PNevins971/TeamAvalanche/Notes and Research/uc_to_antenna - schematic draft - Dmitrii.docx

Using the formula below (source (https://physics.nyu.edu/~physlab/GenPhysI_PhysII/Intro_experimental_physicsII_write_ups/Magnetic-field-circular-coil_01_30_2017.pdf))

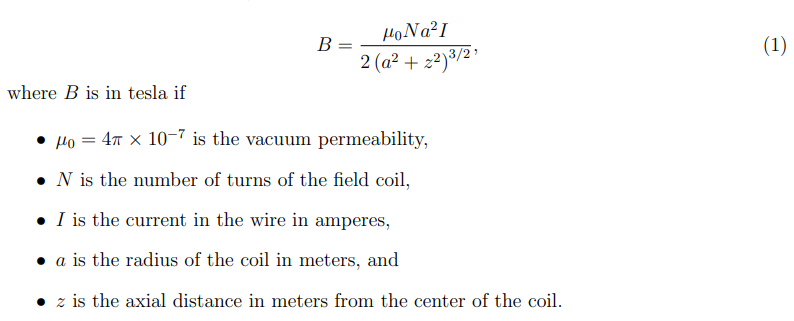
[picture p1: figure]

The current to output to antenna is estimated to be 2 A:

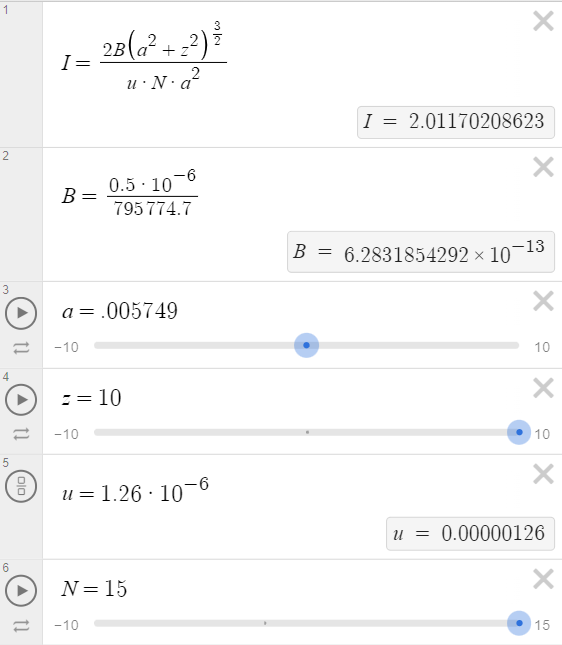
[picture p2: figure]

This can be achieved with the circuit below:

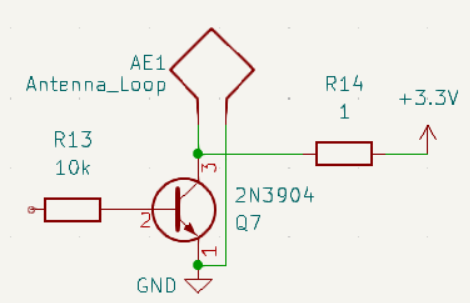
[picture p3: figure]
