PNevins971/TeamAvalanche/Breadboard_Layout_bb.pdf

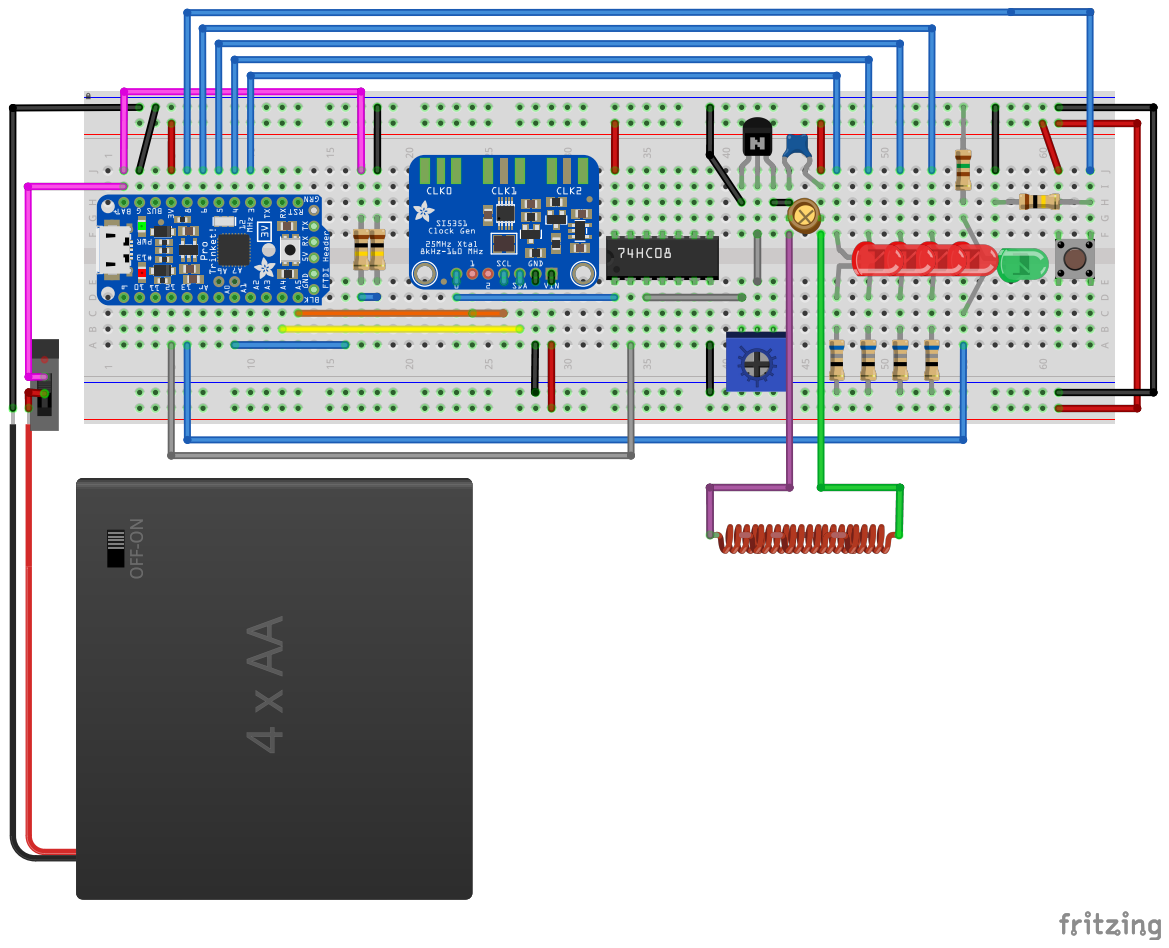
[picture p17: page 1]
