PNevins971/TeamAvalanche/(list of files, drawings)

Other design files:
Breadboard_Layout.fzz
