PNevins971/TeamAvalanche/PCB_design/avalanche_transmitter.kicad_pcb

## KiCad design PCB_design/avalanche_transmitter.kicad_pcb (2024-05-27)

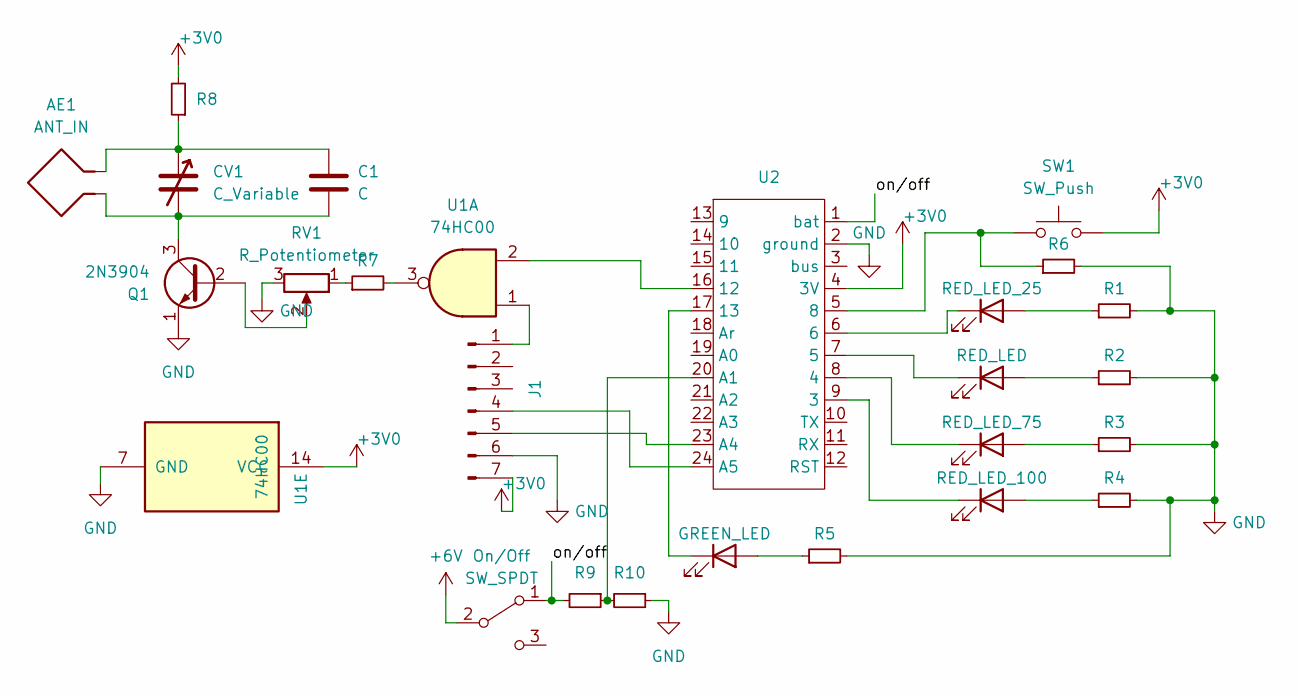
[picture p18: schematic avalanche_transmitter.kicad_sch]

Parts:
25%: RED_LED_100; LED_D5.0mm
50%: RED_LED_75; LED_D5.0mm
75%: RED_LED; LED_D5.0mm
100%: RED_LED_25; LED_D5.0mm
AE1: ANT_IN; PinHeader_1x02_P2.54mm_Vertical
C1: C; C_Disc_D4.7mm_W2.5mm_P5.00mm
CV1: C_Variable; C_Disc_D4.7mm_W2.5mm_P5.00mm
J1: Conn_01x07_Pin; PinHeader_1x07_P2.54mm_Vertical
On/Off: SW_SPDT; PinHeader_1x03_P2.54mm_Vertical
Q1: 2N3904; TO-92_Inline
R1, R2, R3, R4, R5, R6, R7, R8, R9, R10: R_Small; R_Axial_DIN0204_L3.6mm_D1.6mm_P7.62mm_Horizontal
RV1: R_Potentiometer; Potentiometer_Bourns_3296W_Vertical
SW1: SW_Push
TRANSMITTING: GREEN_LED; LED_D5.0mm
U1: 74HC00; DIP-14_W7.62mm
U2: pro_mini

Connections:
+3V0: J1.7, R8.2, SW1.2, U1.14 (VCC), U2.4 (3V)
+6V: On/Off.2 (B); also elsewhere on the board
/on/off: On/Off.1 (A), R9.2, U2.1 (bat)
GND: J1.6, Q1.1 (E), R1.2, R2.2, R3.2, R4.2, R5.2, R6.2, R10.1, RV1.3, U1.7 (GND), U2.2 (ground); also elsewhere on the board
unnamed: 75%.2 (A), R2.1
unnamed: 75%.1 (K), U2.7 (5)
unnamed: 50%.2 (A), R3.1
unnamed: 50%.1 (K), U2.8 (4)
unnamed: 25%.2 (A), R4.1
unnamed: 25%.1 (K), U2.9 (3)
unnamed: AE1.2, C1.1, CV1.1, R8.1
unnamed: 100%.2 (A), R1.1
unnamed: 100%.1 (K), U2.6
unnamed: J1.1, U1.1
unnamed: J1.4, U2.24 (A5)
unnamed: J1.5, U2.23 (A4)
unnamed: Q1.2 (B), RV1.2
unnamed: AE1.1, C1.2, CV1.2, Q1.3 (C)
unnamed: R7.1, RV1.1
unnamed: R7.2, U1.3
unnamed: R5.1, TRANSMITTING.2 (A)
unnamed: TRANSMITTING.1 (K), U2.17 (13)
unnamed: R6.1, SW1.1, U2.5 (8)
unnamed: U1.2, U2.16 (12)
unnamed: R9.1, R10.2, U2.20 (A1)

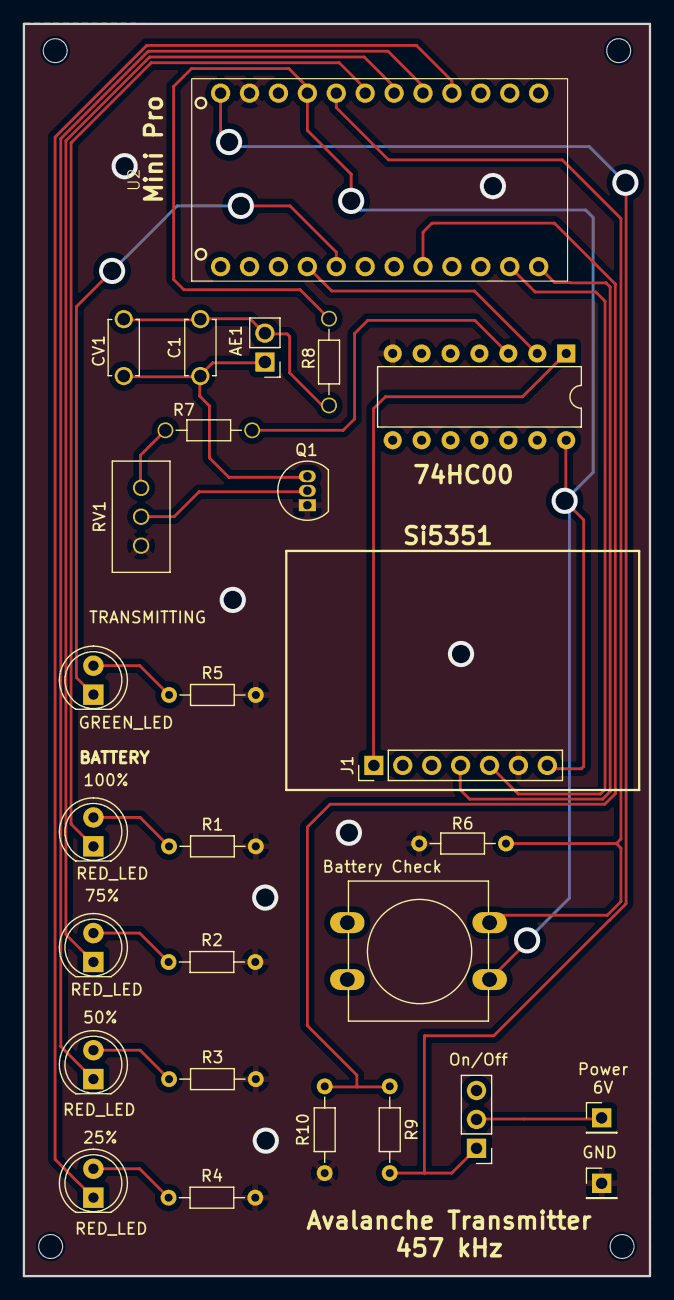
[picture p19: board avalanche_transmitter.kicad_pcb from above]

Board: 2 copper layers, 55.0 x 110.0 mm, 26 parts (0 on the bottom side), 25 nets.

Other parts of the board:
Battery In (6V): PinHeader_1x01_P2.54mm_Vertical
GND: PinHeader_1x01_P2.54mm_Vertical

Their connections:
+6V: Battery In (6V).1; also elsewhere on the board
GND: GND.1; also elsewhere on the board
