PNevins971/TeamAvalanche/(commit log)

2024-04-05 code to program IC via raspberry pi i2c
2024-04-09 Update si5351_init.ino
    tested on adafruit trinket
    and rasp pi pico
2024-04-16 Update arduinoTrinketCode_withDigitalSW.txt
    Removed adafruit si library only using etherkit library.
    Removed clockgen functions.
    Tested and functioning at freq and programmed duty cycle
2024-04-16 Updated Design Log
    Updated with 4/16 changes including images from scope of freq and duty cycle using transistor for switching
2024-04-22 Create uc_to_antenna - schematic draft - Dmitrii.docx
2024-05-15 PCB initial layout
    [avalanche_transmitter.kicad_pcb, avalanche_transmitter.kicad_sch]
2024-05-15 edited layout
    [avalanche_transmitter.kicad_pcb]
2024-05-17 PCB updates
    Added some vias, rerouted some things, changed the footprint for the SI
    [avalanche_transmitter.kicad_pcb, avalanche_transmitter.kicad_sch]
2024-05-17 added series resistor to increase magfield
    [avalanche_transmitter.kicad_pcb, avalanche_transmitter.kicad_sch]
2024-05-18 finished PCB. ready for bens review
    [avalanche_transmitter.kicad_pcb, avalanche_transmitter.kicad_sch]
2024-05-18 updated layout. ready for review again
    [avalanche_transmitter.kicad_pcb, avalanche_transmitter.kicad_sch]
2024-05-22 adjusted pin connectors on PCB to lead to vias with red wires
    [avalanche_transmitter.kicad_pcb, avalanche_transmitter.kicad_sch]
2024-05-22 Changes ben recommended made
    added on/off switch
    added resistor in series with antenna
    swapped LEDs to correct direction
    [avalanche_transmitter.kicad_pcb]
2024-05-22 QOL additions
    ready to print
    [avalanche_transmitter.kicad_pcb]
2024-05-22 Added Battery Check Code and Green Tx Light
    Still needs code cleanup and comments
2024-05-22 Added voltage divider for battery check
    [avalanche_transmitter.kicad_pcb]
2024-05-22 Manufacturing QOL updates
    Moved some traces
    [avalanche_transmitter.kicad_pcb]
2024-05-26 Final PCB
    [avalanche_transmitter-B_Cu.gbr, avalanche_transmitter-B_Mask.gbr, avalanche_transmitter-B_Paste.gbr, avalanche_transmitter-B_Silkscreen.gbr, avalanche_transmitter-Edge_Cuts.gbr, avalanche_transmitter-F_Cu.gbr, avalanche_transmitter-F_Mask.gbr, avalanche_transmitter-F_Paste.gbr]
2024-05-26 var cap pin hole size updated
    [avalanche_transmitter.kicad_pcb]
2024-05-27 adjusted MCU footprint and hole diameter
    [avalanche_transmitter.kicad_pcb]
2024-05-27 pcb finished
    pcb finished. gerber files and source uploaded
    receipt for oshpark print in folder
    [avalanche_transmitter-B_Cu.gbr, avalanche_transmitter-B_Mask.gbr, avalanche_transmitter-B_Paste.gbr, avalanche_transmitter-B_Silkscreen.gbr, avalanche_transmitter-Edge_Cuts.gbr, avalanche_transmitter-F_Cu.gbr, avalanche_transmitter-F_Mask.gbr, avalanche_transmitter-F_Paste.gbr]
2024-06-11 Upload Circtui Fritzing Diagram
    [Breadboard_Layout.fzz]
